ThiefMaster/rotaryboard/schematics/rotaryboard-layout.png

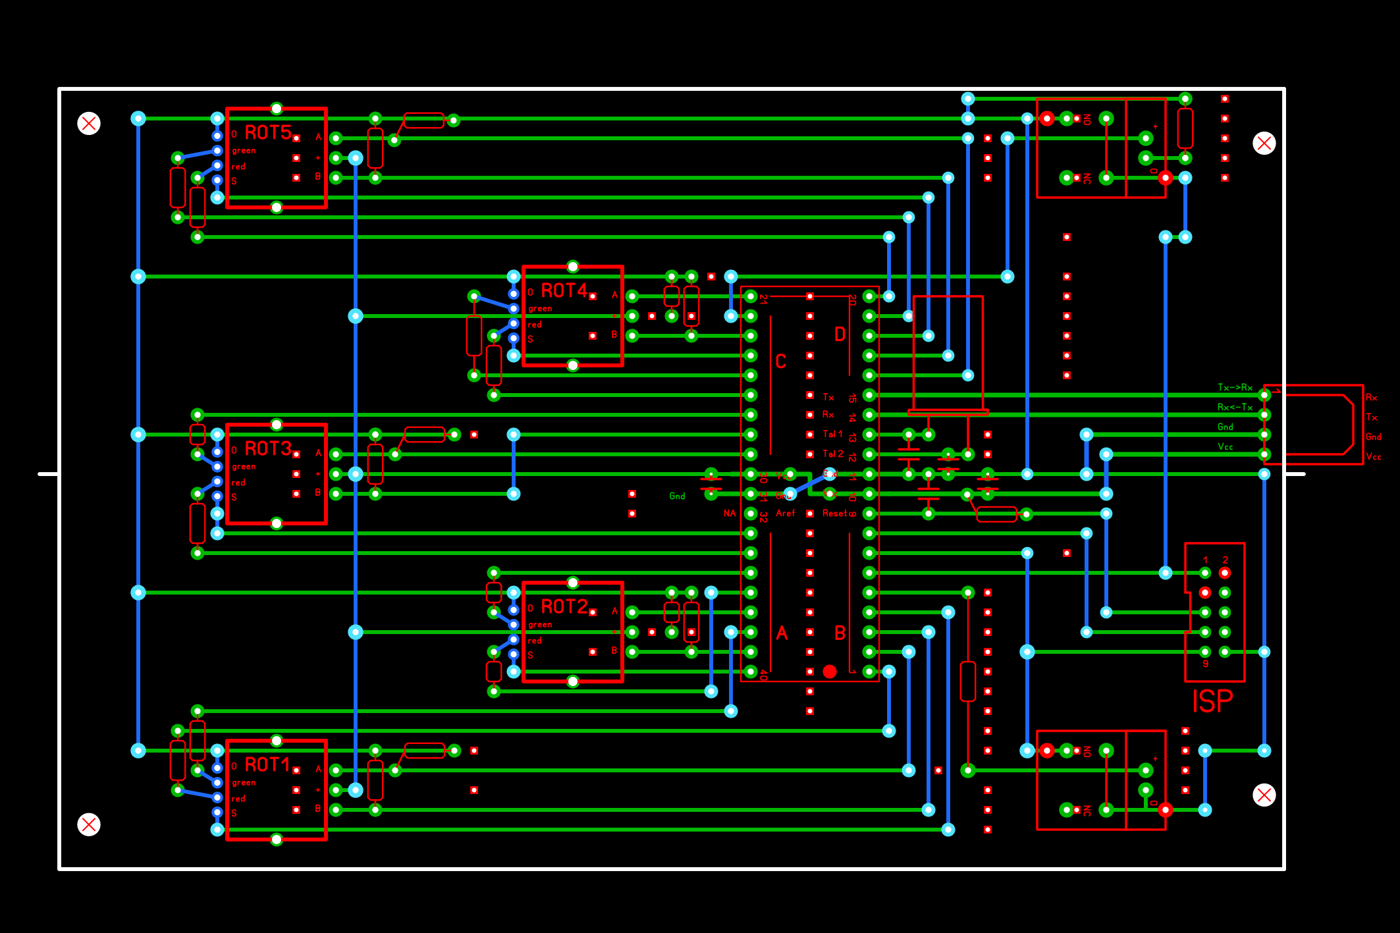
schematics/rotaryboard-layout.png
