ThiefMaster/rotaryboard/schematics/rotaryboard-small-layout.png

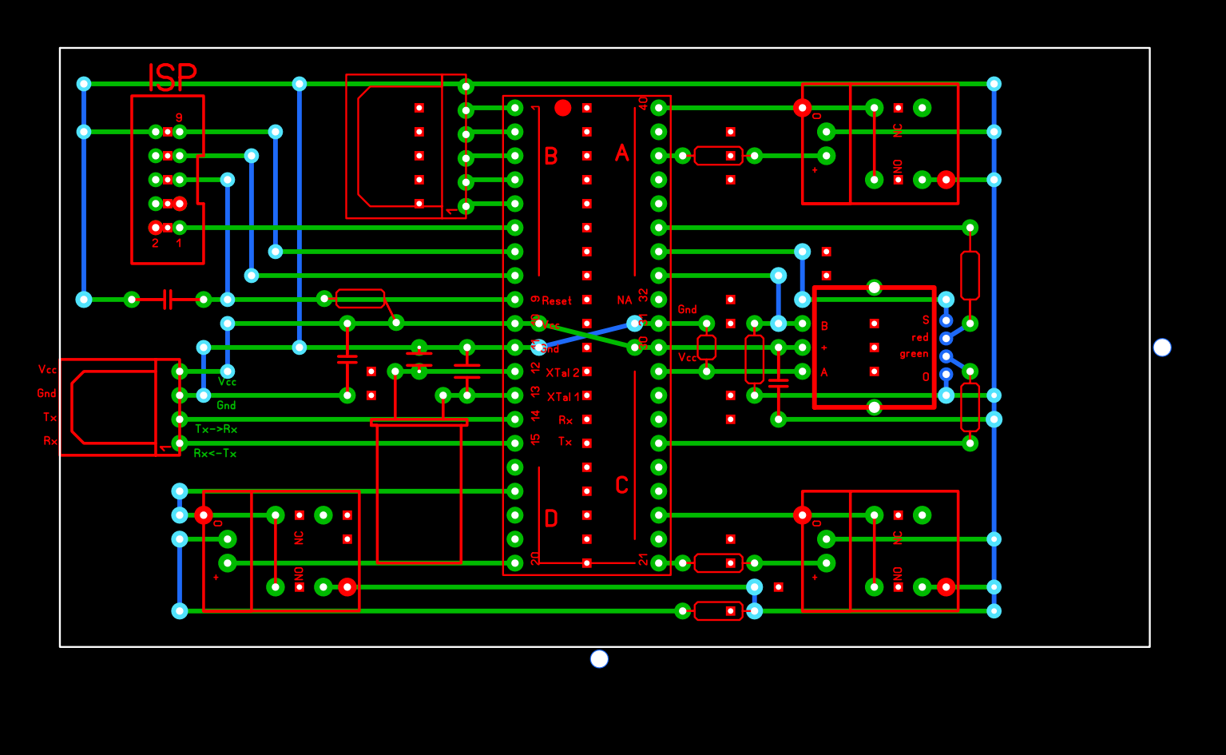
schematics/rotaryboard-small-layout.png
