ThiefMaster/rotaryboard/schematics/rotaryboard-small.png

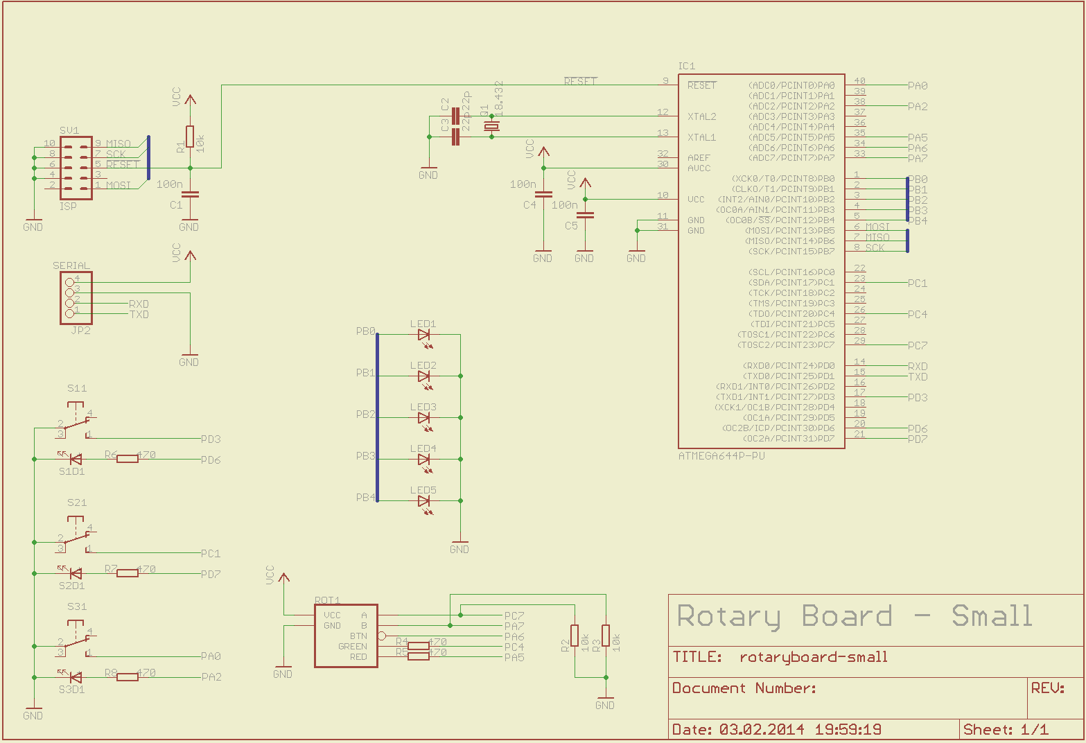
schematics/rotaryboard-small.png
