ThiefMaster/rotaryboard/schematics/rotaryboard.png

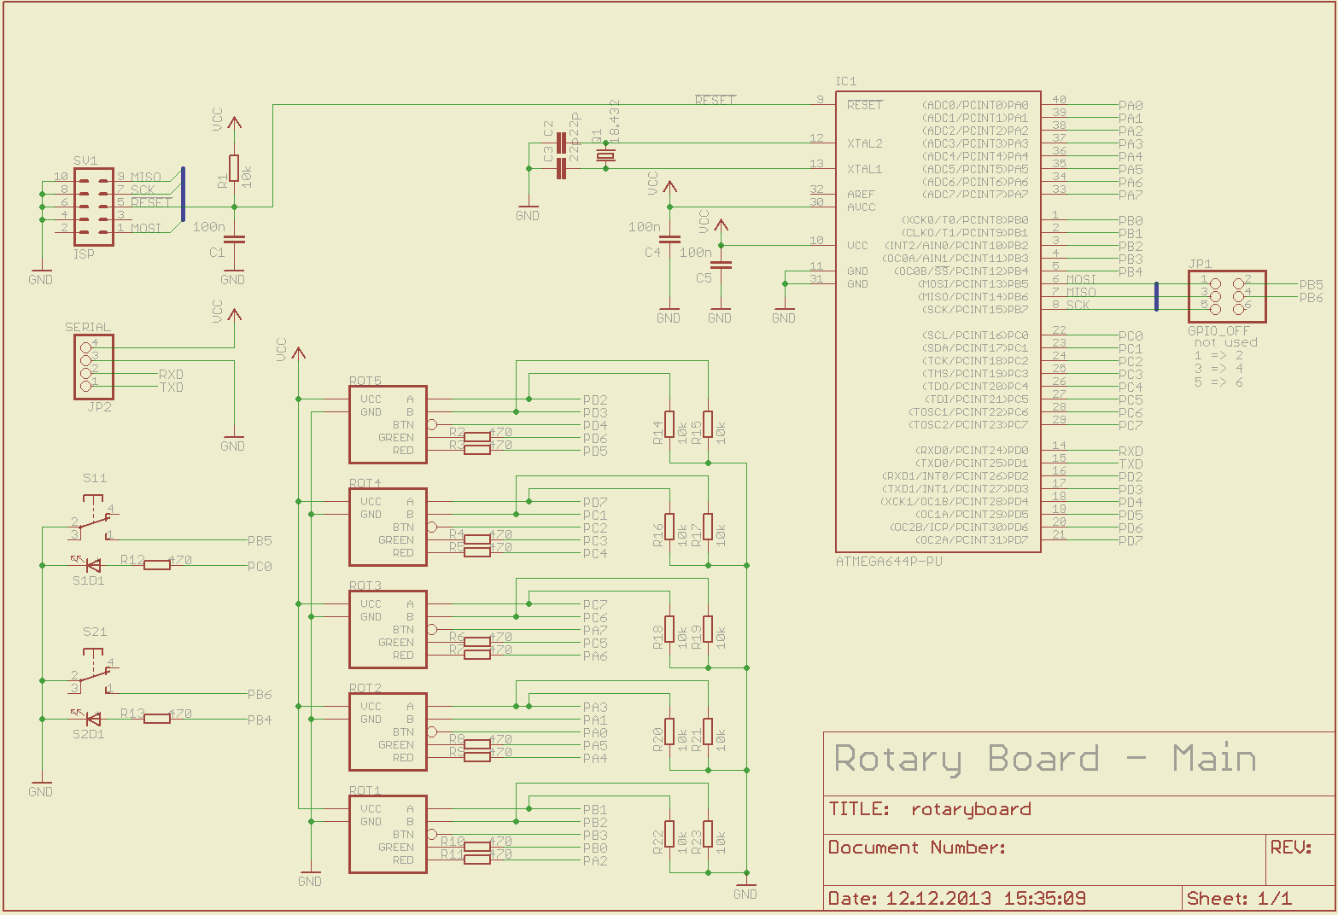
schematics/rotaryboard.png
