ThiefMaster/rotaryboard/(list of files, drawings)

Other design files:
schematics/rotaryboard-small.lay6
schematics/rotaryboard.lay6
