ThiefMaster/rotaryboard/schematics/rotaryboard-small.sch

## EAGLE design schematics/rotaryboard-small.sch (2014-02-05)

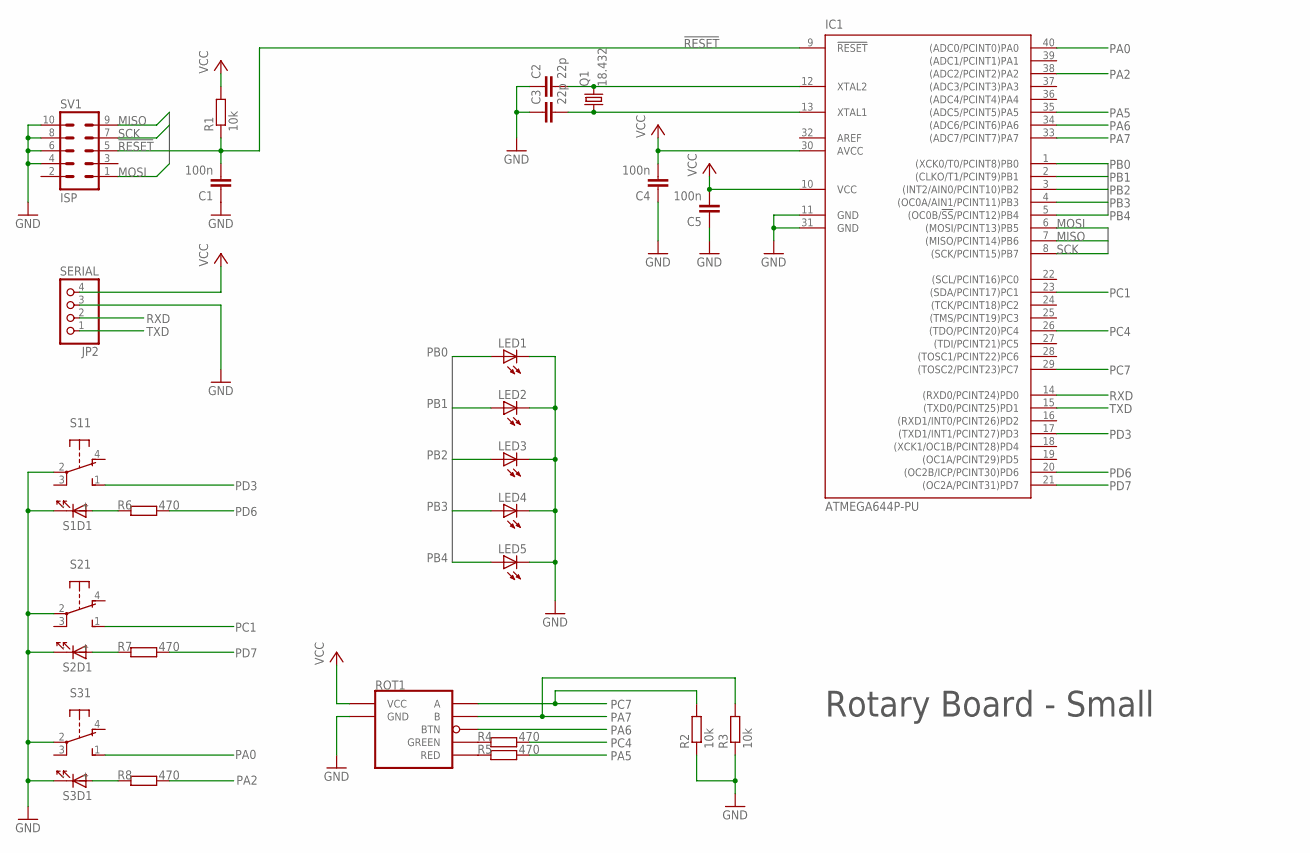
[picture p5: schematic rotaryboard-small.sch]

Parts:
C1, C4, C5: 100n; C050-025X075
C2, C3: 22p; C050-025X075
IC1: ATMEGA644P-PU; DIL40
JP2: SERIAL; 1X04
LED1, LED2, LED3, LED4, LED5: LED3MM
Q1: 18.432; HC18U-V
R1, R2, R3: 10k; 0207/10
R4, R5, R6, R7, R8: 470; 0207/10
ROT1: DPL12SVCUSTOM; DPL12SV
S1, S2, S3: SRKL
SV1: ISP; ML10

Connections:
!RESET: C1.2, IC1.9 (!RESET), R1.1, SV1.5
GND: C1.1, C2.1, C3.1, C4.1, C5.1, IC1.11 (GND), IC1.31 (GND), JP2.3, LED1.K (C), LED2.K (C), LED3.K (C), LED4.K (C), LED5.K (C), R2.1, R3.1, ROT1.GND, S1.2, S1.- (C), S2.2, S2.- (C), S3.2, S3.- (C), SV1.4, SV1.6, SV1.8, SV1.10
MISO: IC1.7 ((MISO/PCINT14)PB6), SV1.9
MOSI: IC1.6 ((MOSI/PCINT13)PB5), SV1.1
unnamed: C3.2, IC1.13 (XTAL1), Q1.1
unnamed: C2.2, IC1.12 (XTAL2), Q1.2
unnamed: R8.2, S3.+ (A)
unnamed: R4.2, ROT1.GREEN
unnamed: R5.2, ROT1.RED
unnamed: R7.2, S2.+ (A)
unnamed: R6.2, S1.+ (A)
PA0: IC1.40 ((ADC0/PCINT0)PA0), S3.1 (S)
PA2: IC1.38 ((ADC2/PCINT2)PA2), R8.1
PA5: IC1.35 ((ADC5/PCINT5)PA5), R5.1
PA6: IC1.34 ((ADC6/PCINT6)PA6), ROT1.BTN
PA7: IC1.33 ((ADC7/PCINT7)PA7), R3.2, ROT1.B
PB0: IC1.1 ((XCK0/T0/PCINT8)PB0), LED1.A
PB1: IC1.2 ((CLKO/T1/PCINT9)PB1), LED2.A
PB2: IC1.3 ((INT2/AIN0/PCINT10)PB2), LED3.A
PB3: IC1.4 ((OC0A/AIN1/PCINT11)PB3), LED4.A
PB4: IC1.5 ((OC0B/!SS!/PCINT12)PB4), LED5.A
PC1: IC1.23 ((SDA/PCINT17)PC1), S2.1 (S)
PC4: IC1.26 ((TDO/PCINT20)PC4), R4.1
PC7: IC1.29 ((TOSC2/PCINT23)PC7), R2.2, ROT1.A
PD3: IC1.17 ((TXD1/INT1/PCINT27)PD3), S1.1 (S)
PD6: IC1.20 ((OC2B/ICP/PCINT30)PD6), R6.1
PD7: IC1.21 ((OC2A/PCINT31)PD7), R7.1
RXD: IC1.14 ((RXD0/PCINT24)PD0), JP2.2
SCK: IC1.8 ((SCK/PCINT15)PB7), SV1.7
TXD: IC1.15 ((TXD0/PCINT25)PD1), JP2.1
VCC: C4.2, C5.2, IC1.10 (VCC), IC1.30 (AVCC), JP2.4, R1.2, ROT1.VCC

Notes on the sheet:
Rotary Board - Small
