ThiefMaster/rotaryboard/schematics/rotaryboard.sch

## EAGLE design schematics/rotaryboard.sch (2013-12-12)

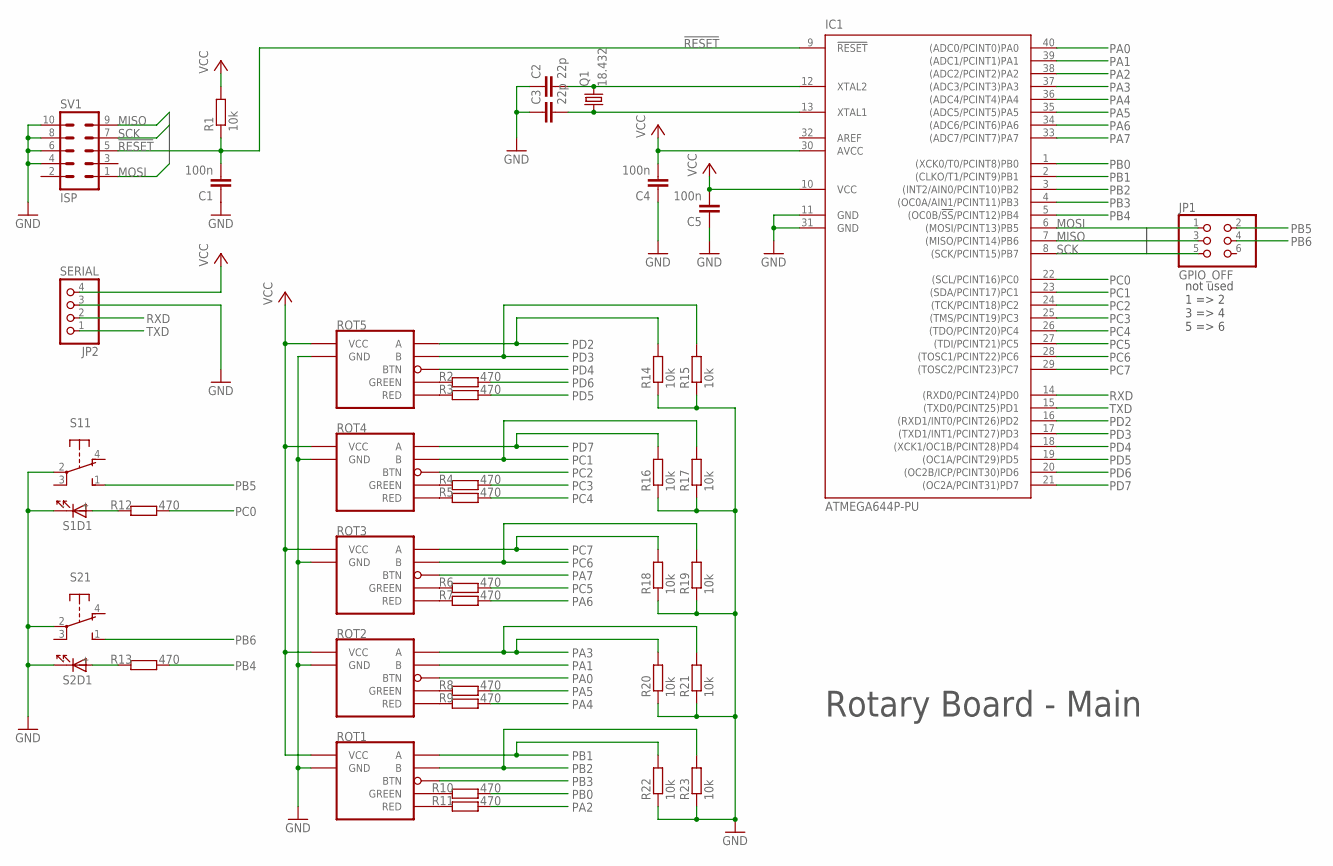
[picture p6: schematic rotaryboard.sch]

Parts:
C1, C4, C5: 100n; C050-025X075
C2, C3: 22p; C050-025X075
IC1: ATMEGA644P-PU; DIL40
JP1: GPIO_OFF; 2X03
JP2: SERIAL; 1X04
Q1: 18.432; HC18U-V
R1, R14, R15, R16, R17, R18, R19, R20, R21, R22, R23: 10k; 0207/10
R2, R3, R4, R5, R6, R7, R8, R9, R10, R11, R12, R13: 470; 0207/10
ROT1, ROT2, ROT3, ROT4, ROT5: DPL12SVCUSTOM; DPL12SV
S1, S2: SRKL
SV1: ISP; ML10

Connections:
!RESET: C1.2, IC1.9 (!RESET), R1.1, SV1.5
GND: C1.1, C2.1, C3.1, C4.1, C5.1, IC1.11 (GND), IC1.31 (GND), JP2.3, R14.1, R15.1, R16.1, R17.1, R18.1, R19.1, R20.1, R21.1, R22.1, R23.1, ROT1.GND, ROT2.GND, ROT3.GND, ROT4.GND, ROT5.GND, S1.2, S1.- (C), S2.2, S2.- (C), SV1.4, SV1.6, SV1.8, SV1.10
MISO: IC1.7 ((MISO/PCINT14)PB6), JP1.3, SV1.9
MOSI: IC1.6 ((MOSI/PCINT13)PB5), JP1.1, SV1.1
unnamed: C3.2, IC1.13 (XTAL1), Q1.1
unnamed: C2.2, IC1.12 (XTAL2), Q1.2
unnamed: R2.2, ROT5.GREEN
unnamed: R3.2, ROT5.RED
unnamed: R4.2, ROT4.GREEN
unnamed: R5.2, ROT4.RED
unnamed: R6.2, ROT3.GREEN
unnamed: R7.2, ROT3.RED
unnamed: R8.2, ROT2.GREEN
unnamed: R9.2, ROT2.RED
unnamed: R10.2, ROT1.GREEN
unnamed: R11.2, ROT1.RED
unnamed: R13.2, S2.+ (A)
unnamed: R12.2, S1.+ (A)
PA0: IC1.40 ((ADC0/PCINT0)PA0), ROT2.BTN
PA1: IC1.39 ((ADC1/PCINT1)PA1), ROT2.B
PA2: IC1.38 ((ADC2/PCINT2)PA2), R11.1
PA3: IC1.37 ((ADC3/PCINT3)PA3), R20.2, R21.2, ROT2.A
PA4: IC1.36 ((ADC4/PCINT4)PA4), R9.1
PA5: IC1.35 ((ADC5/PCINT5)PA5), R8.1
PA6: IC1.34 ((ADC6/PCINT6)PA6), R7.1
PA7: IC1.33 ((ADC7/PCINT7)PA7), ROT3.BTN
PB0: IC1.1 ((XCK0/T0/PCINT8)PB0), R10.1
PB1: IC1.2 ((CLKO/T1/PCINT9)PB1), R22.2, ROT1.A
PB2: IC1.3 ((INT2/AIN0/PCINT10)PB2), R23.2, ROT1.B
PB3: IC1.4 ((OC0A/AIN1/PCINT11)PB3), ROT1.BTN
PB4: IC1.5 ((OC0B/!SS!/PCINT12)PB4), R13.1
PB5: JP1.2, S1.1 (S)
PB6: JP1.4, S2.1 (S)
PC0: IC1.22 ((SCL/PCINT16)PC0), R12.1
PC1: IC1.23 ((SDA/PCINT17)PC1), R17.2, ROT4.B
PC2: IC1.24 ((TCK/PCINT18)PC2), ROT4.BTN
PC3: IC1.25 ((TMS/PCINT19)PC3), R4.1
PC4: IC1.26 ((TDO/PCINT20)PC4), R5.1
PC5: IC1.27 ((TDI/PCINT21)PC5), R6.1
PC6: IC1.28 ((TOSC1/PCINT22)PC6), R19.2, ROT3.B
PC7: IC1.29 ((TOSC2/PCINT23)PC7), R18.2, ROT3.A
PD2: IC1.16 ((RXD1/INT0/PCINT26)PD2), R14.2, ROT5.A
PD3: IC1.17 ((TXD1/INT1/PCINT27)PD3), R15.2, ROT5.B
PD4: IC1.18 ((XCK1/OC1B/PCINT28)PD4), ROT5.BTN
PD5: IC1.19 ((OC1A/PCINT29)PD5), R3.1
PD6: IC1.20 ((OC2B/ICP/PCINT30)PD6), R2.1
PD7: IC1.21 ((OC2A/PCINT31)PD7), R16.2, ROT4.A
RXD: IC1.14 ((RXD0/PCINT24)PD0), JP2.2
SCK: IC1.8 ((SCK/PCINT15)PB7), JP1.5, SV1.7
TXD: IC1.15 ((TXD0/PCINT25)PD1), JP2.1
VCC: C4.2, C5.2, IC1.10 (VCC), IC1.30 (AVCC), JP2.4, R1.2, ROT1.VCC, ROT2.VCC, ROT3.VCC, ROT4.VCC, ROT5.VCC

Notes on the sheet:
Rotary Board - Main
not used 1 => 2 3 => 4 5 => 6
