ThiefMaster/rotaryboard/(commit log)

2013-12-12 Fix pullup macros for inputs
    [rotary.c, rotary.h]
2013-12-12 Update firmware for the real board
2013-12-12 Add support for button/led-only inputs
    A bit hacky since it uses the rotary "library"...
2013-12-12 Add schematics and pcb layout
    [rotaryboard.lay6, rotaryboard.sch]
2014-02-05 Add smaller board
    [rotaryboard-small.lay6, rotaryboard-small.sch]
